nikolaristic1995/Choice_Maker/Master rad/literatura/presek razvodnika.PNG

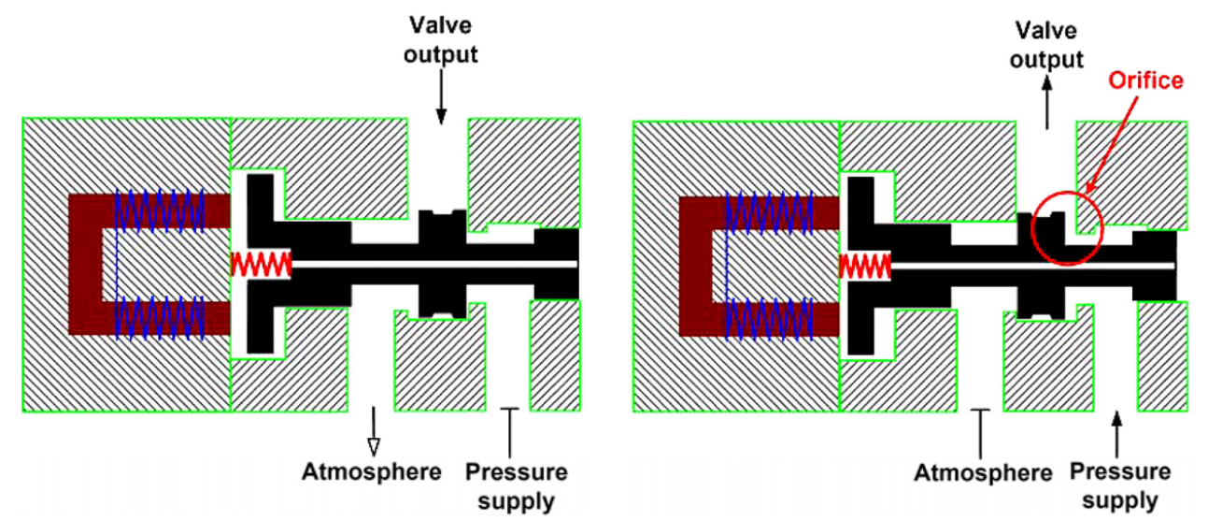
Master rad/literatura/presek razvodnika.PNG
