nikolaristic1995/Choice_Maker/Master rad/slike/aktuator realni/realni/viber_image_2020-09-10_22-50-06.jpg

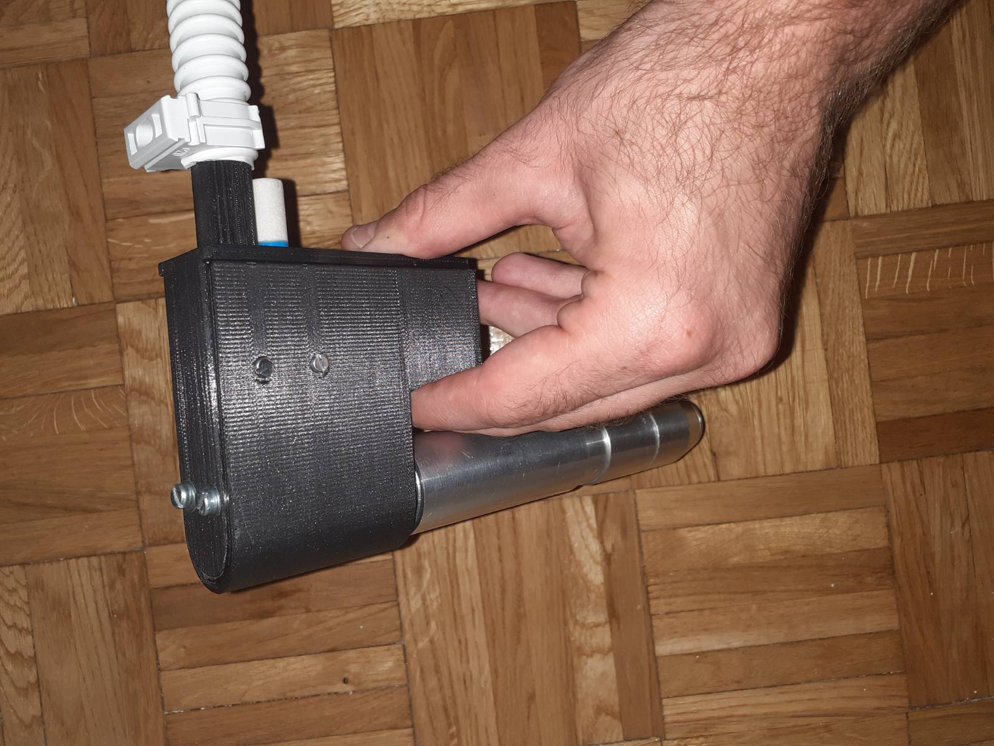
Master rad/slike/aktuator realni/realni/viber_image_2020-09-10_22-50-06.jpg
