nikolaristic1995/Choice_Maker/Master rad/word dokument/ispraviti.docx

skalarni i vektorski proizvod

razmak zarez i ‘i’ kod rednog nabrajanja

naslov promeni

uvecaj sliku projektila i membrane

font 12

crvena boja znaci obrisi, zuta je ispravljeno

reference treba redom da idu

referenca na zumiran prikaz projektila

slika8b

poziv na sliku 3-6 zica

pod povlakama oznaciti ulazne velicine

definisati zadatak u uvodu

dudic i srki

tabela eliminisi boje

dodaj nove slike i novi prilog 1

reference moraju da imaju i mesto izadavanja

Dodaj brojeve strana kako treba i sadržaj i listu slika i tabela

podesiti margine, 15 mm je ono sto si sublerom izmerio odstupanje

proveriti naslovnu stranu, da li će je preći 15 mm

Proveri sa Tanjom da li si dobro napisao zahvalincu za Vuleta

Eliminisati referencu pored dve tacke

zavrsi rad

dodai deo za zauljen vazduh pod pritiskom

1. DONE
2. NS steel zovi u četvrtak. Četvrtak brusi deo za slikanje i ureži navoje kod boba. Slikaj. Posalji Vuletu rad.
3. Zapiši poslednje poglavlje. Napiši zaključak.
4. Uneti nove slike aktuatora
5. Srediti broj strana, listu slika i tabela i sadržaj napravi
6. Pretvori u pdf i revidiraj.
7. Napravi prezentaciju.
