nikolaristic1995/Choice_Maker/Master rad/literatura/presek razvodnika i model.PNG

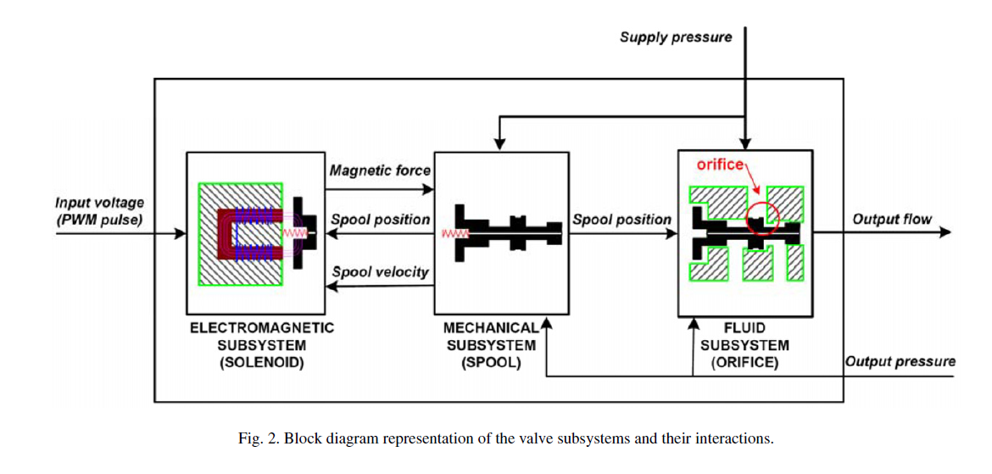
Master rad/literatura/presek razvodnika i model.PNG
