nikolaristic1995/Choice_Maker/Master rad/prezentacija/aktuator.PNG

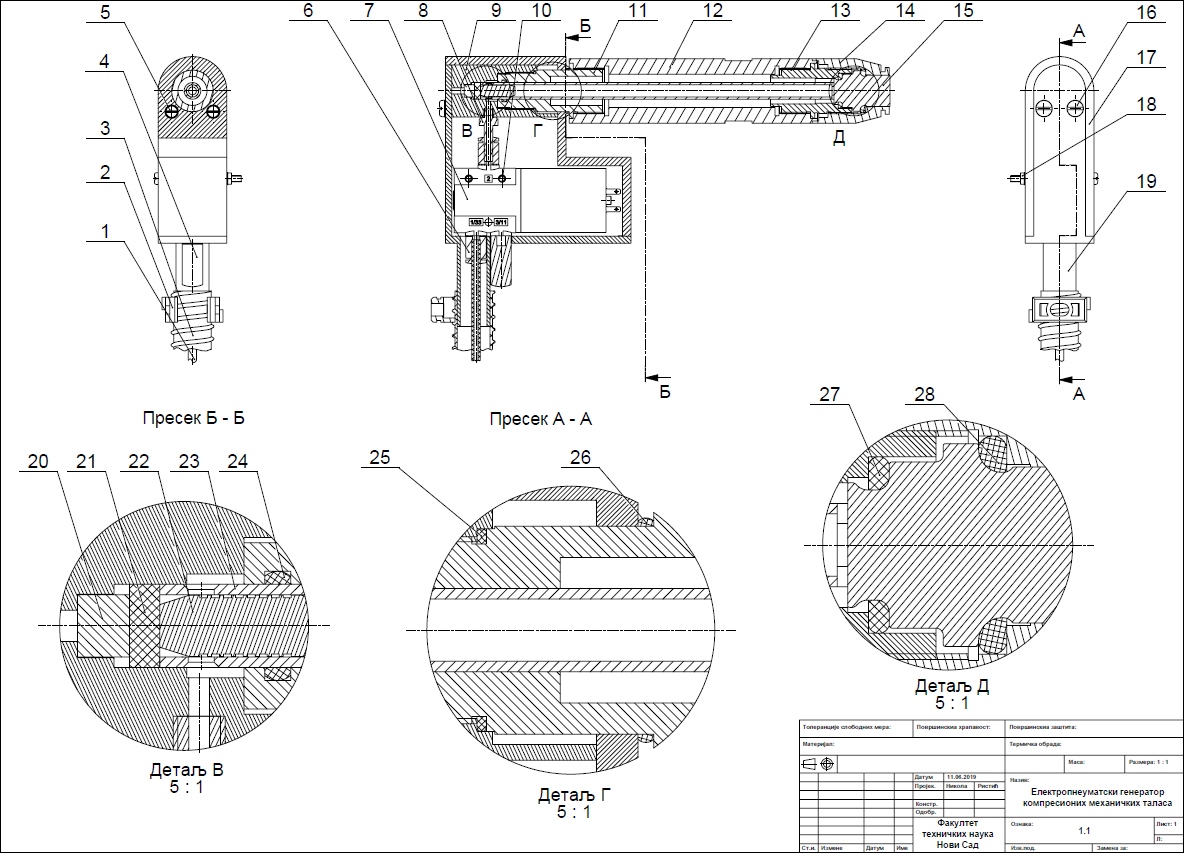
Master rad/prezentacija/aktuator.PNG
