nikolaristic1995/Choice_Maker/Master rad/prezentacija/kutija.PNG

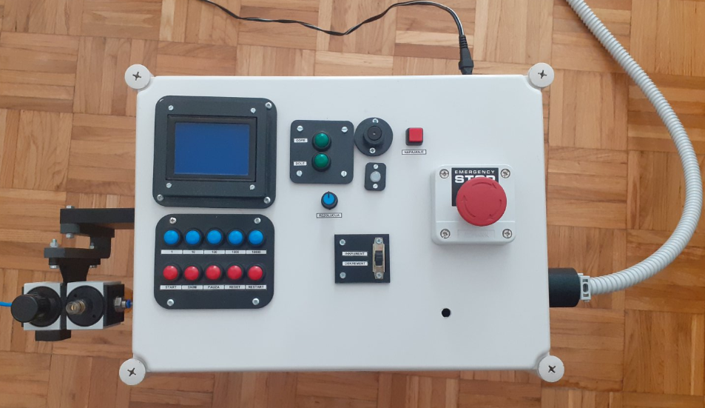
Master rad/prezentacija/kutija.PNG
