nikolaristic1995/Choice_Maker/Master rad/prezentacija/metak krozz cev.PNG

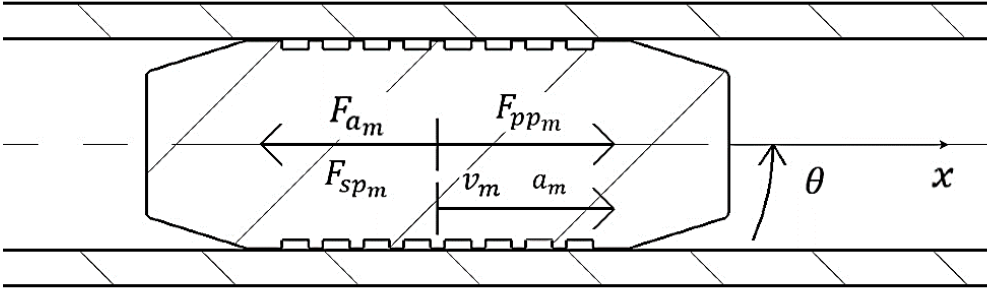
Master rad/prezentacija/metak krozz cev.PNG
