nikolaristic1995/Choice_Maker/Master rad/prezentacija/metak u početnom stanju.PNG

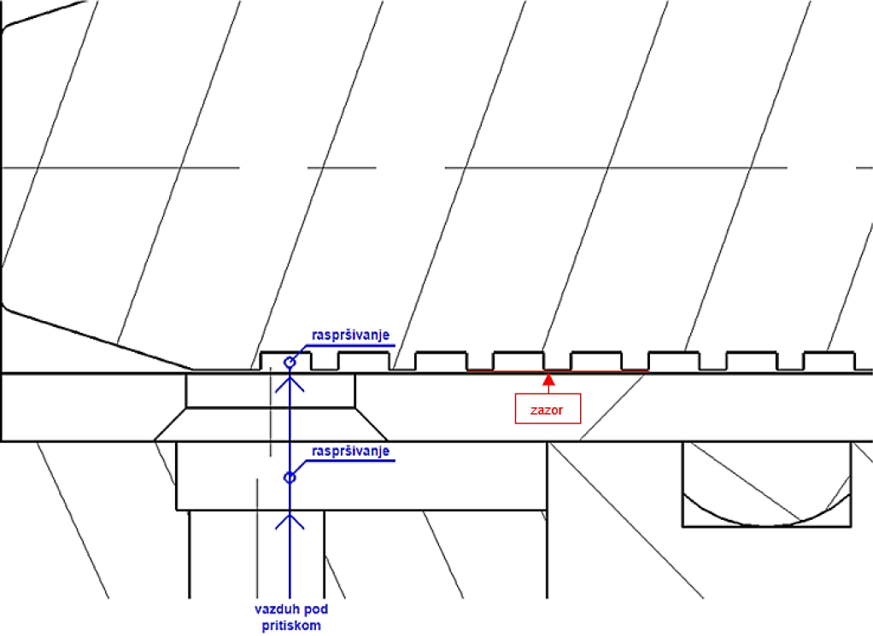
Master rad/prezentacija/metak u početnom stanju.PNG
