nikolaristic1995/Choice_Maker/Master rad/prezentacija/opruga.PNG

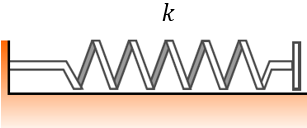
Master rad/prezentacija/opruga.PNG
