nikolaristic1995/Choice_Maker/Master rad/prezentacija/p i t.PNG

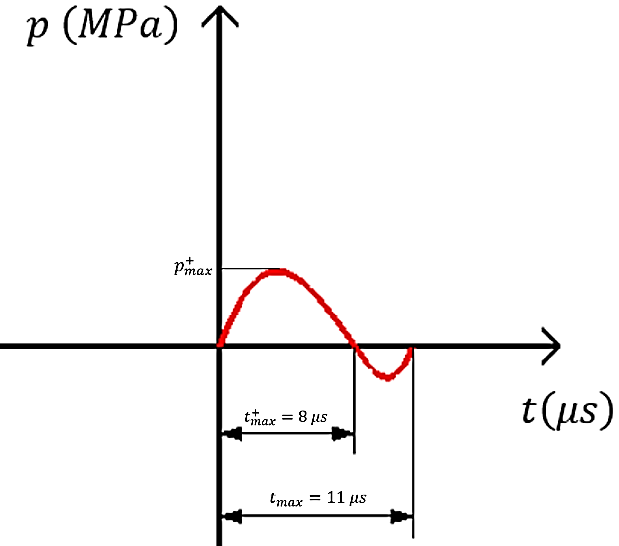
Master rad/prezentacija/p i t.PNG
