nikolaristic1995/Choice_Maker/Master rad/prezentacija/signali ventila.PNG

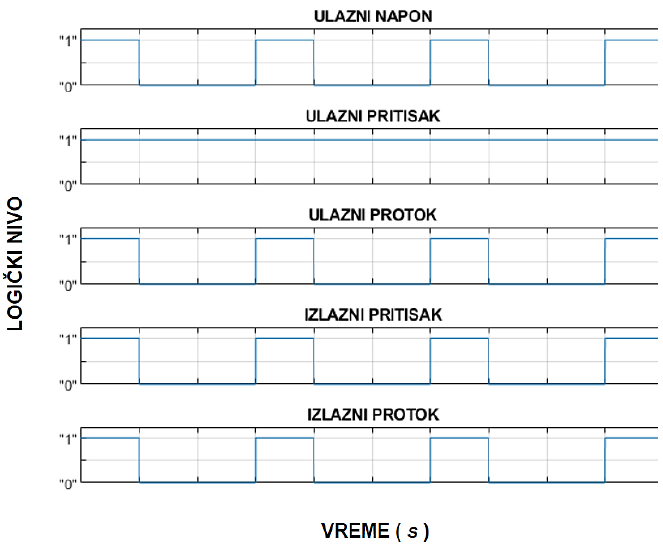
Master rad/prezentacija/signali ventila.PNG
