nikolaristic1995/Choice_Maker/Master rad/prezentacija/sudar1.PNG

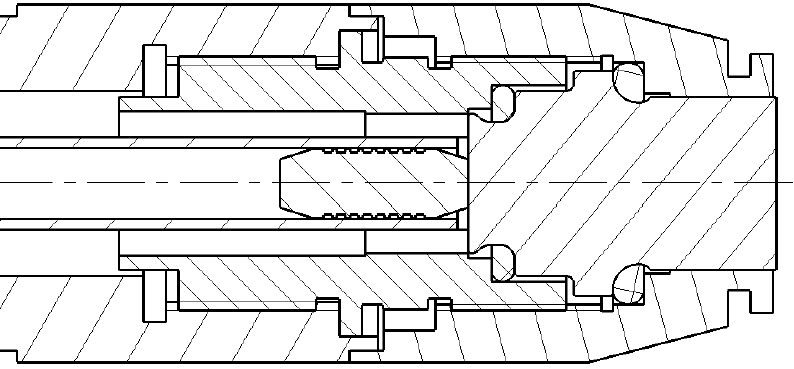
Master rad/prezentacija/sudar1.PNG
