nikolaristic1995/Choice_Maker/Master rad/prezentacija/tok vazduha do spoljašnje cevi.PNG

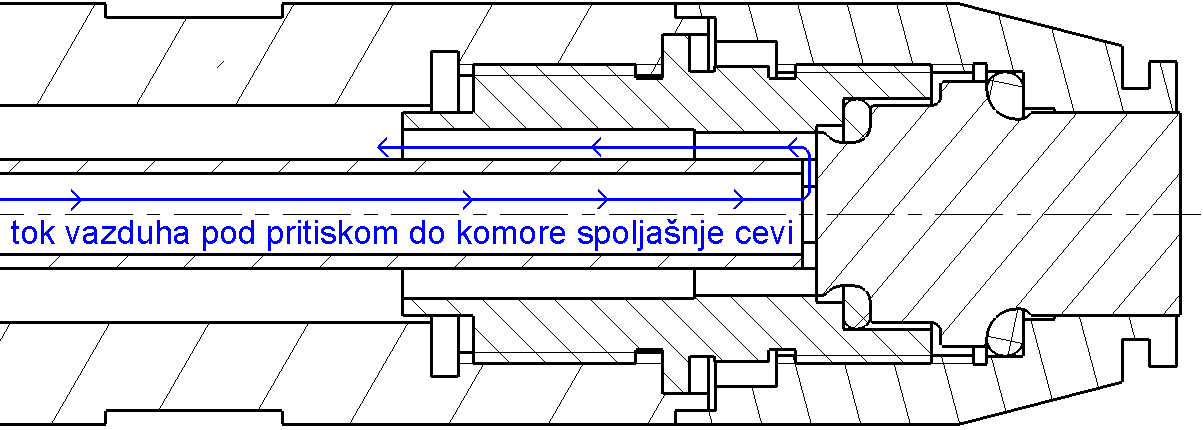
Master rad/prezentacija/tok vazduha do spoljašnje cevi.PNG
