nikolaristic1995/Choice_Maker/Master rad/prezentacija/ventil.PNG

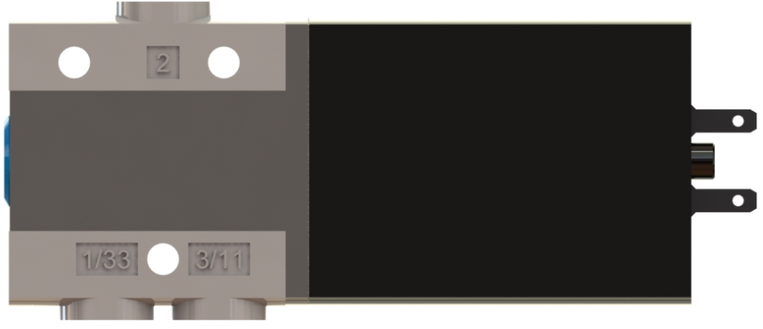
Master rad/prezentacija/ventil.PNG
