nikolaristic1995/Choice_Maker/Master rad/slike/aktuator final.JPG

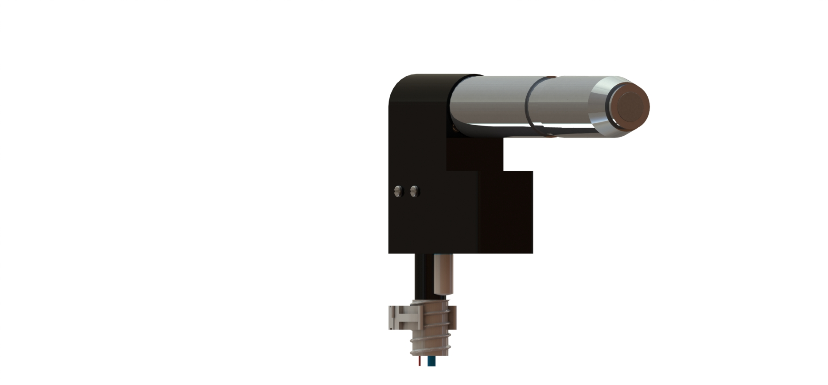
Master rad/slike/aktuator final.JPG
