nikolaristic1995/Choice_Maker/Master rad/slike/aktuator realni/1 - Copy.jpg

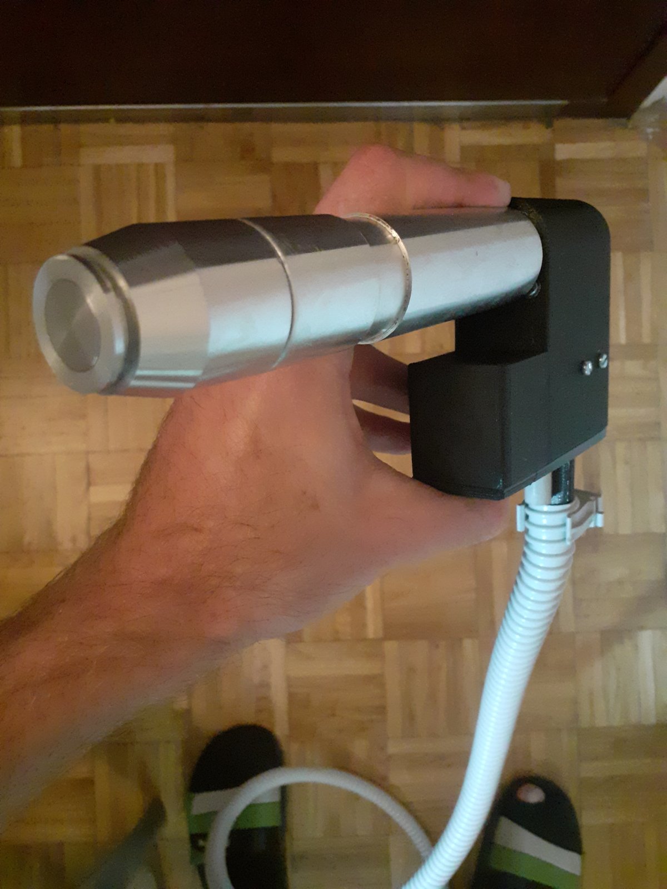
Master rad/slike/aktuator realni/1 - Copy.jpg
