nikolaristic1995/Choice_Maker/Master rad/slike/aktuator realni/2.jpg

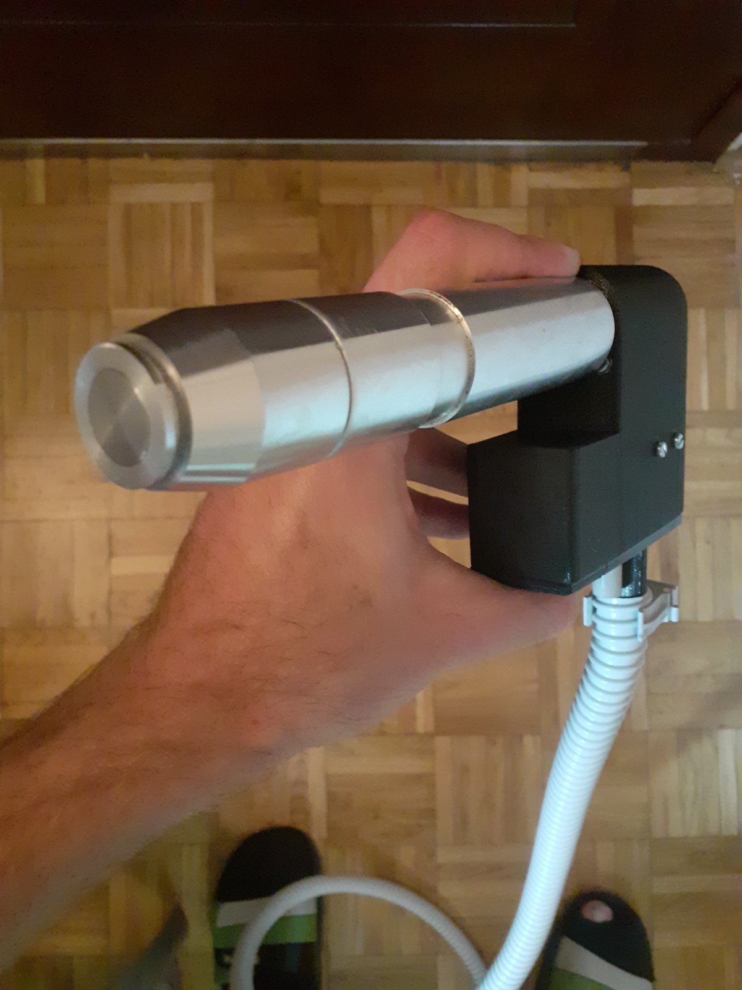
Master rad/slike/aktuator realni/2.jpg
