nikolaristic1995/Choice_Maker/Master rad/slike/aktuator realni/realni/5.jpg

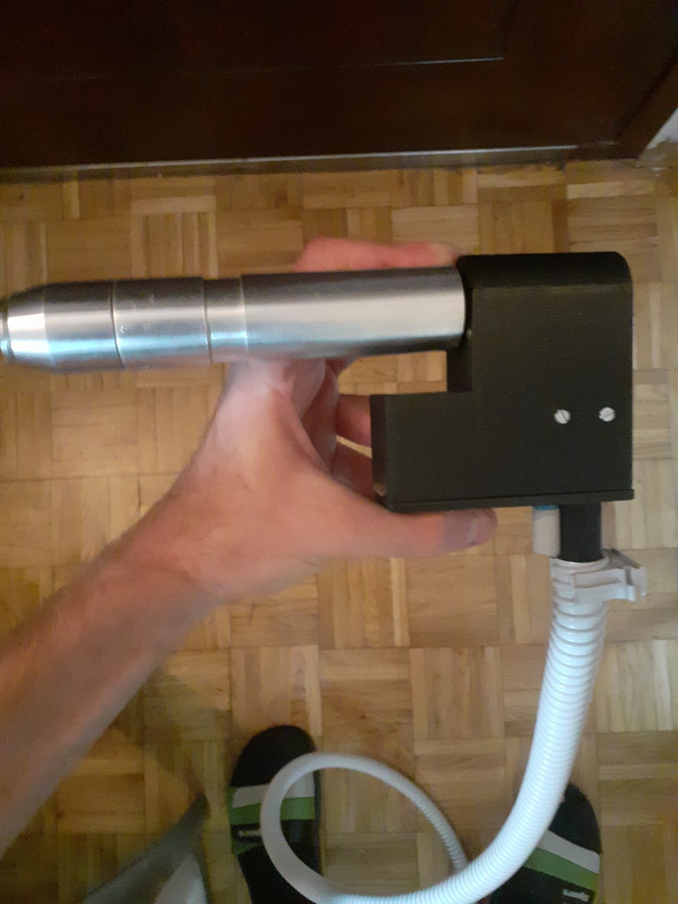
Master rad/slike/aktuator realni/realni/5.jpg
