nikolaristic1995/Choice_Maker/Master rad/slike/aktuator realni/realni/6.jpg

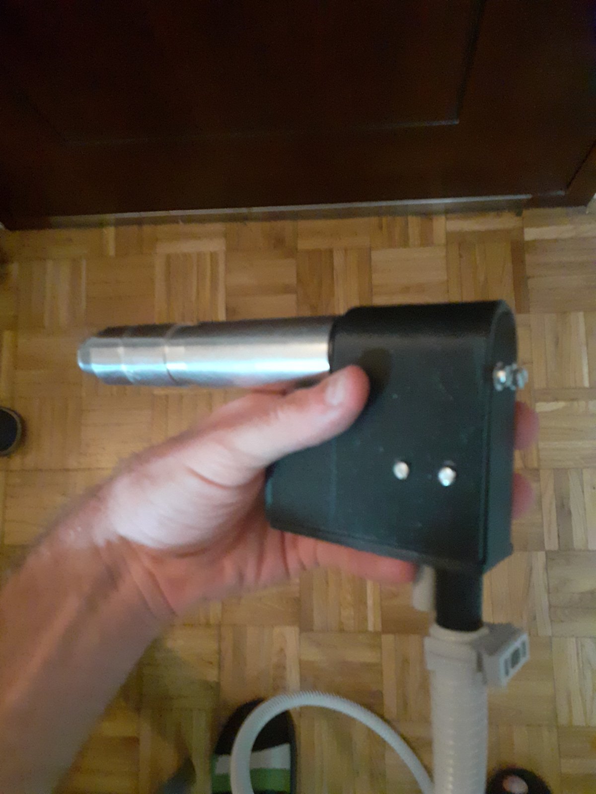
Master rad/slike/aktuator realni/realni/6.jpg
