nikolaristic1995/Choice_Maker/Master rad/slike/aktuator realni/realni/Uspeh horizontalni.jpg

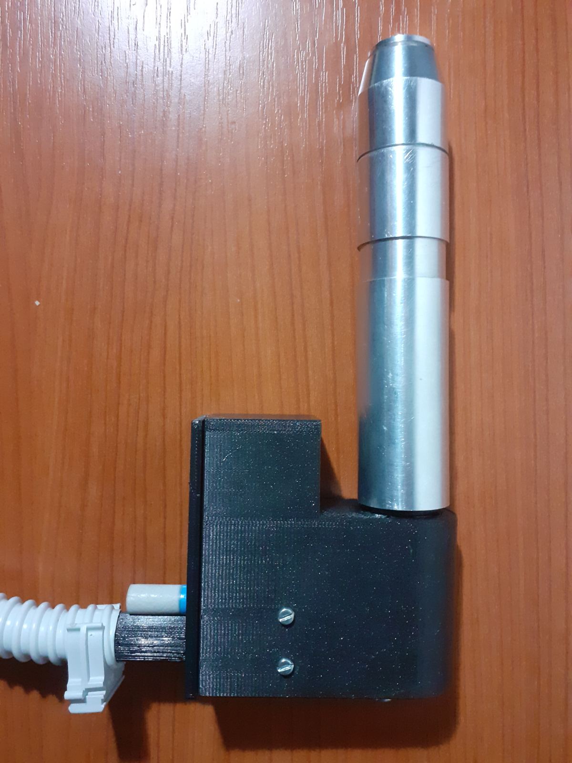
Master rad/slike/aktuator realni/realni/Uspeh horizontalni.jpg
