nikolaristic1995/Choice_Maker/Master rad/slike/aktuator realni/realni/za word1.jpg

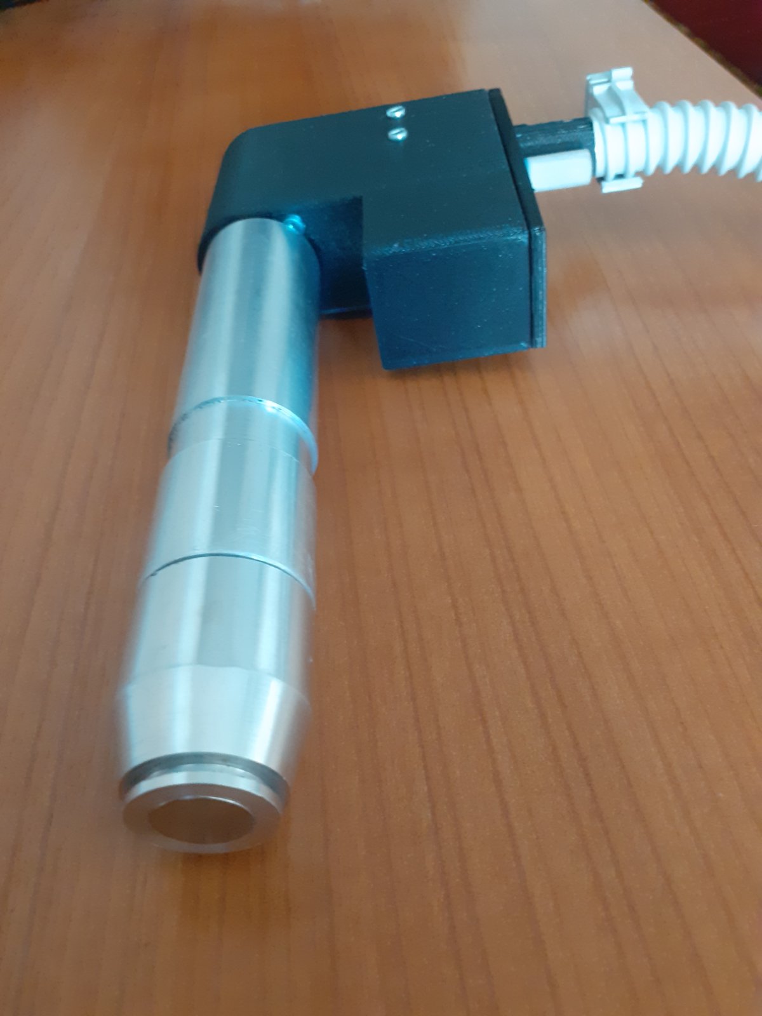
Master rad/slike/aktuator realni/realni/za word1.jpg
