nikolaristic1995/Choice_Maker/Master rad/slike/aktuator realni/USPEH/Capture.PNG

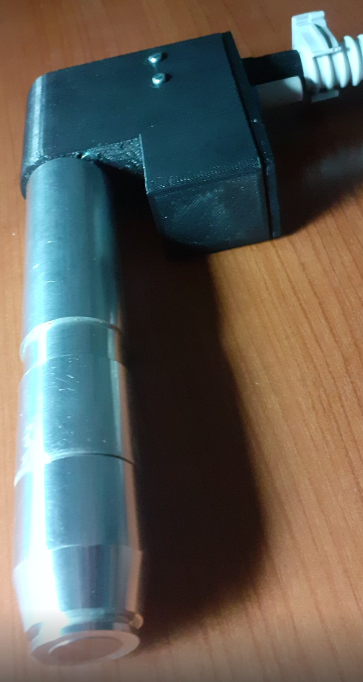
Master rad/slike/aktuator realni/USPEH/Capture.PNG
