nikolaristic1995/Choice_Maker/Master rad/slike/aktuator realni/USPEH/uspeh1.PNG

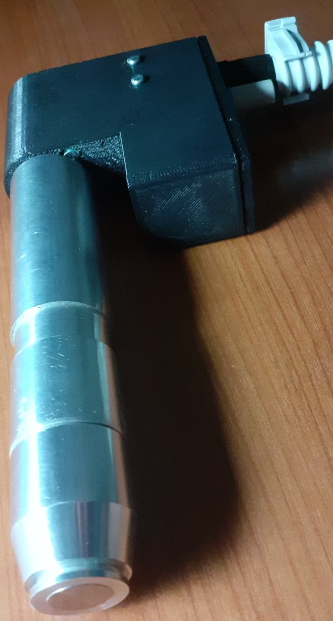
Master rad/slike/aktuator realni/USPEH/uspeh1.PNG
