nikolaristic1995/Choice_Maker/Master rad/slike/baloni na aktuatoru.PNG

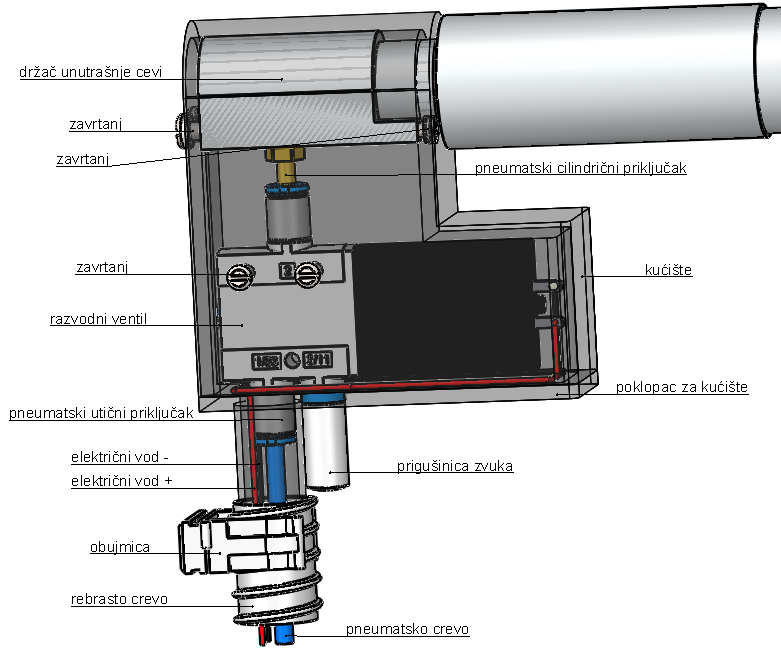
Master rad/slike/baloni na aktuatoru.PNG
