nikolaristic1995/Choice_Maker/Master rad/slike/drugi aktuator.PNG

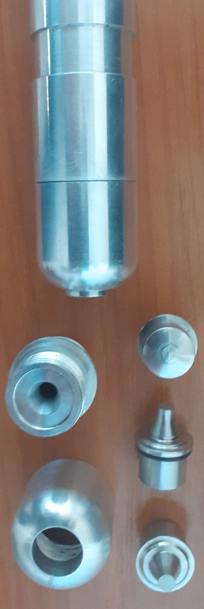
Master rad/slike/drugi aktuator.PNG
