nikolaristic1995/Choice_Maker/Master rad/slike/GLCD2.jpg

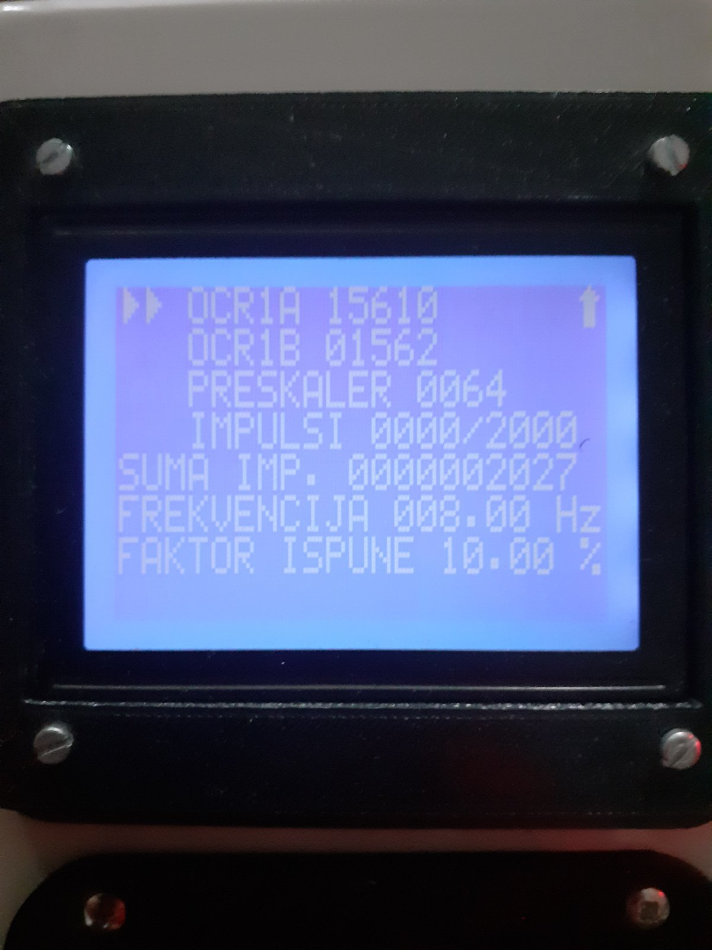
Master rad/slike/GLCD2.jpg
