nikolaristic1995/Choice_Maker/Master rad/slike/glcd.PNG

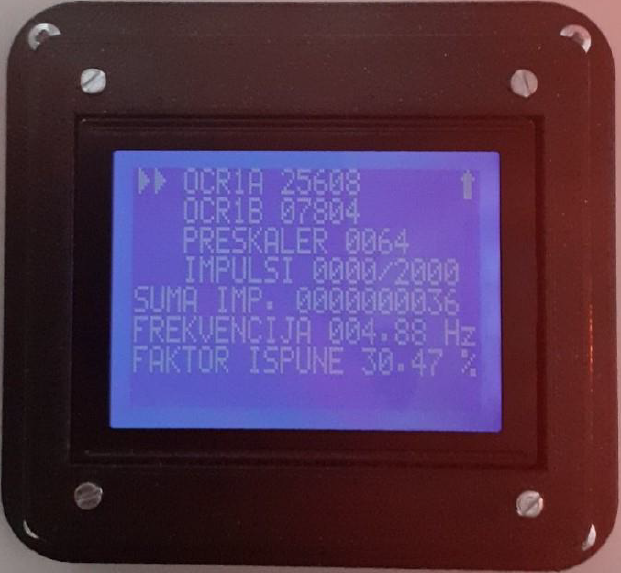
Master rad/slike/glcd.PNG
