nikolaristic1995/Choice_Maker/Master rad/slike/izbušena cev.jpg

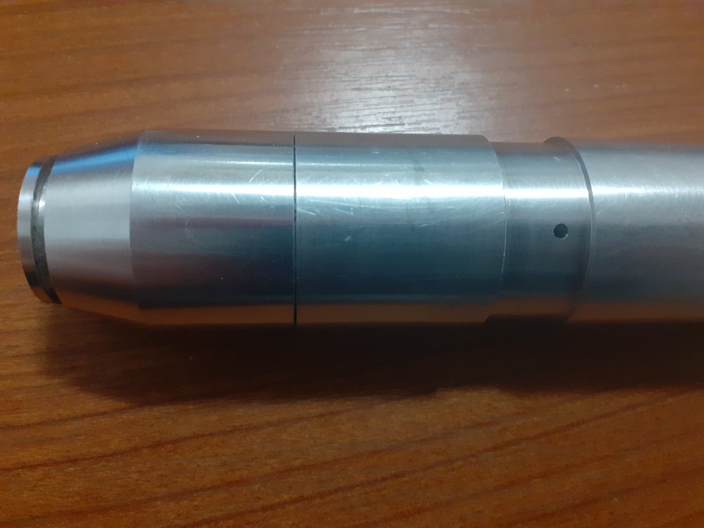
Master rad/slike/izbušena cev.jpg
