nikolaristic1995/Choice_Maker/Master rad/slike/na ovo poloziti kuciste.PNG

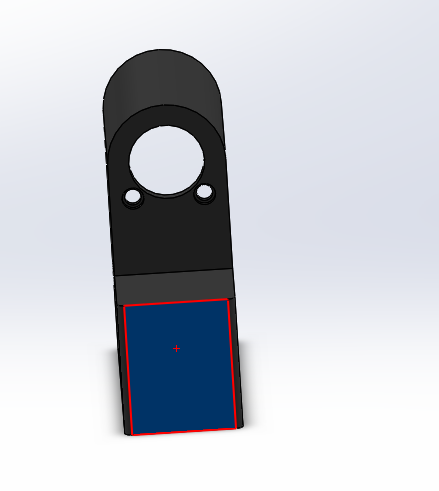
Master rad/slike/na ovo poloziti kuciste.PNG
