nikolaristic1995/Choice_Maker/Master rad/slike/nalik1.JPG

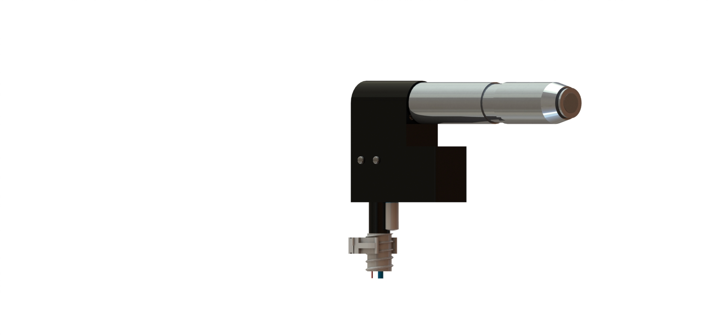
Master rad/slike/nalik1.JPG
