nikolaristic1995/Choice_Maker/Master rad/slike/nalik2.PNG

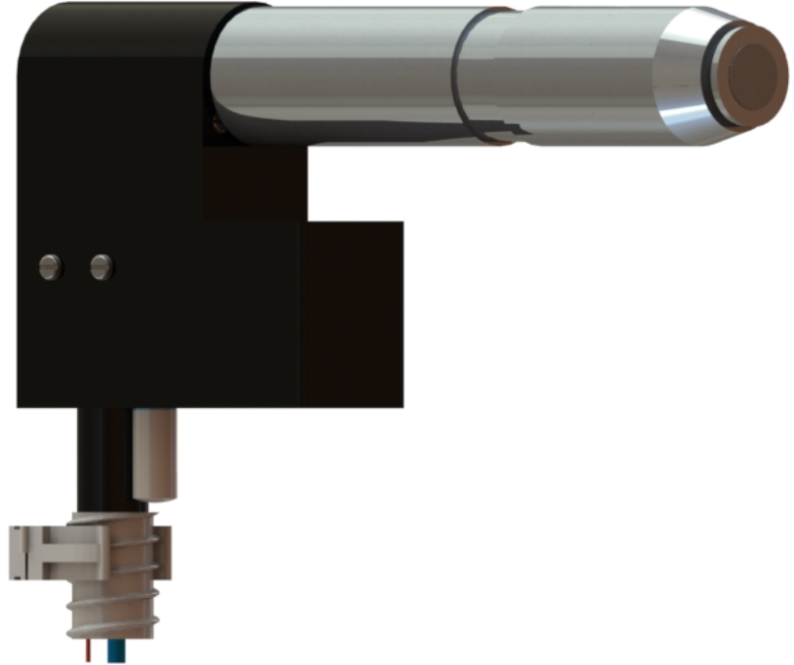
Master rad/slike/nalik2.PNG
