nikolaristic1995/Choice_Maker/Master rad/slike/razvodni ventil.PNG

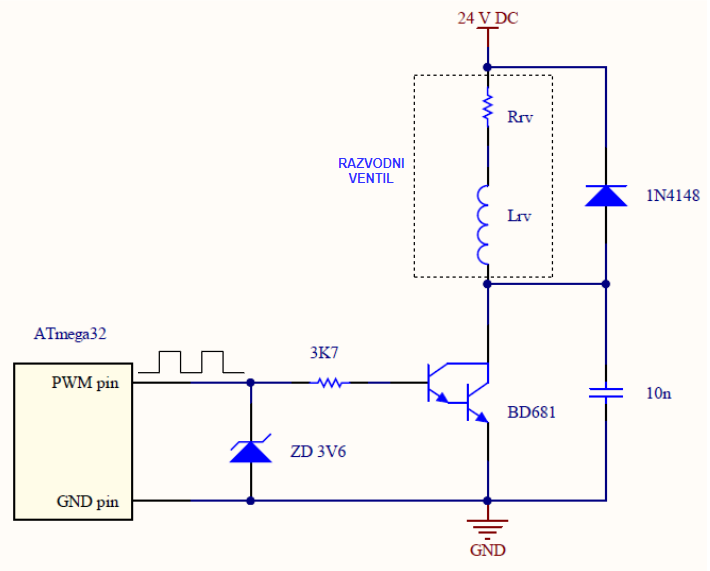
Master rad/slike/razvodni ventil.PNG
