nikolaristic1995/Choice_Maker/Master rad/slike/razvodnik.JPG

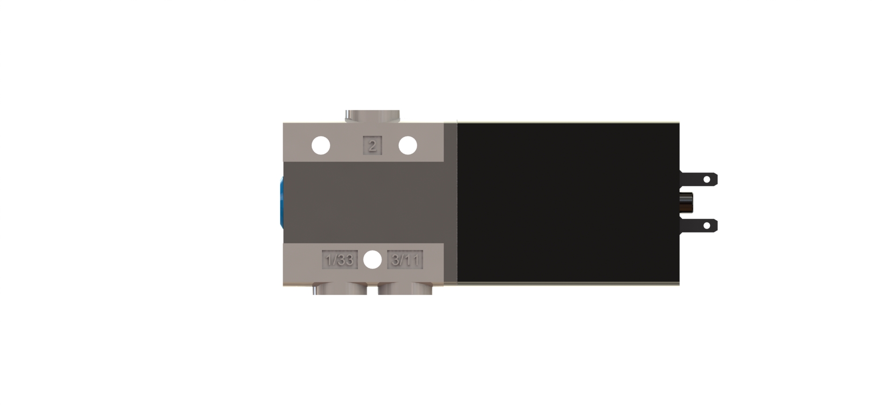
Master rad/slike/razvodnik.JPG
