nikolaristic1995/Choice_Maker/Master rad/slike/Rv.PNG

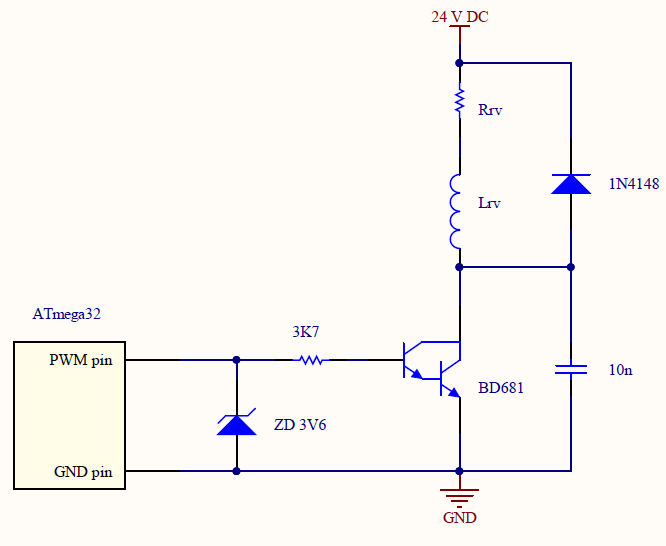
Master rad/slike/Rv.PNG
