nikolaristic1995/Choice_Maker/Master rad/slike/slika drugog aktuatora.jpg

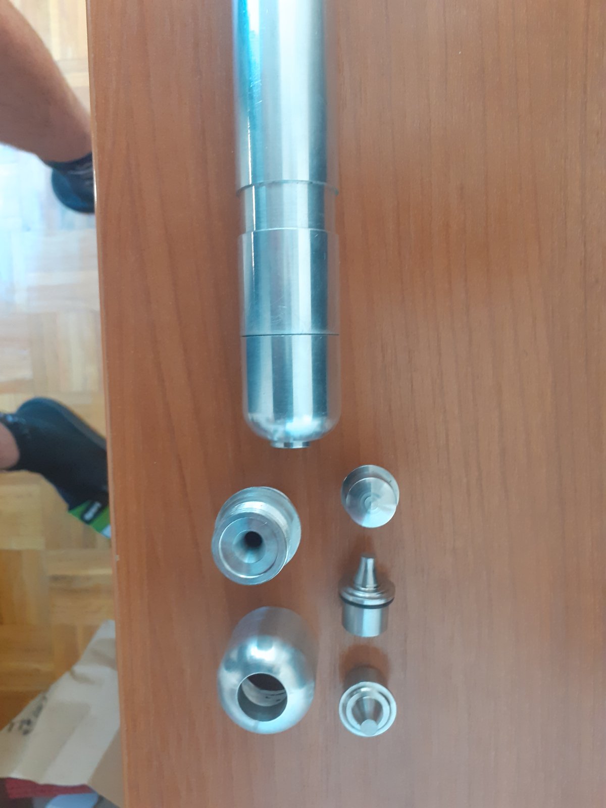
Master rad/slike/slika drugog aktuatora.jpg
