nikolaristic1995/Choice_Maker/Master rad/slike/spawn.PNG

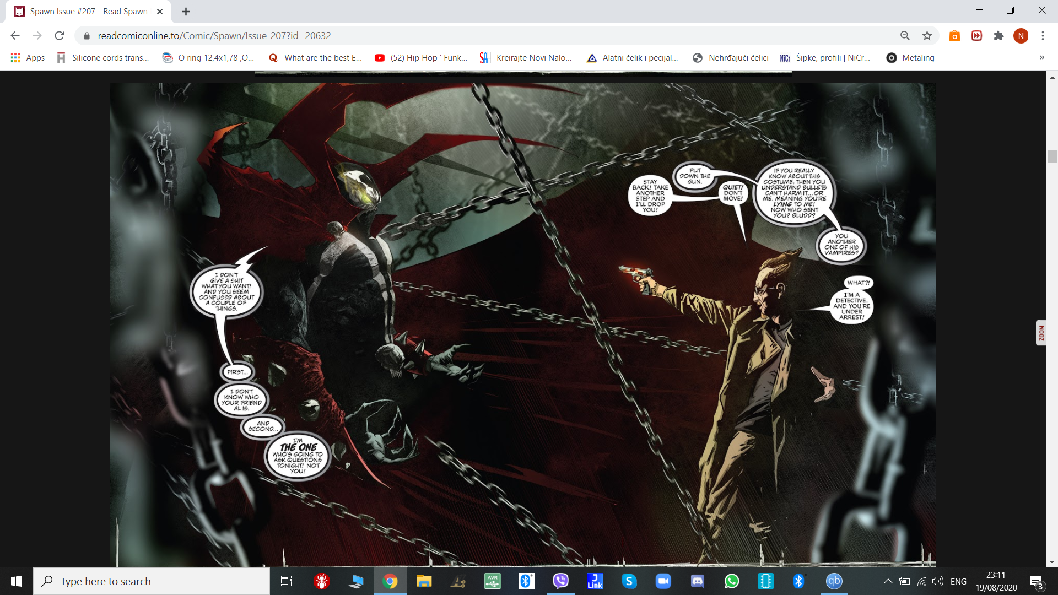
Master rad/slike/spawn.PNG
