nikolaristic1995/Choice_Maker/Master rad/slike/spoljašnja cev sa otvorom.PNG

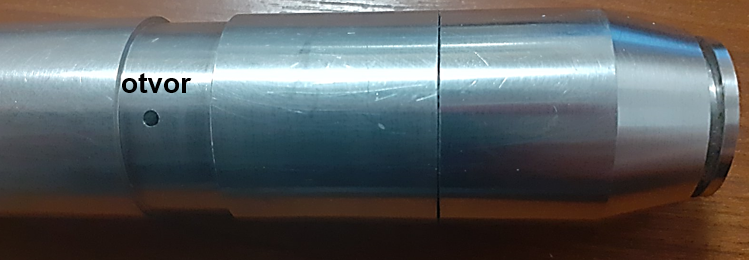
Master rad/slike/spoljašnja cev sa otvorom.PNG
