nikolaristic1995/Choice_Maker/Master rad/slike/talasno polje1.PNG

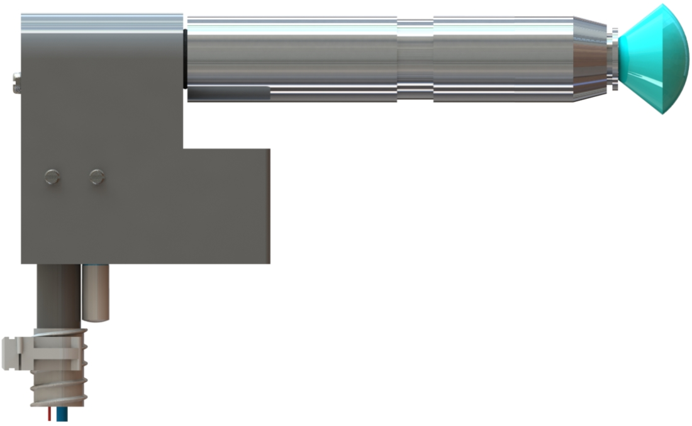
Master rad/slike/talasno polje1.PNG
