nikolaristic1995/Choice_Maker/Master rad/slike/talasno polje 3.PNG

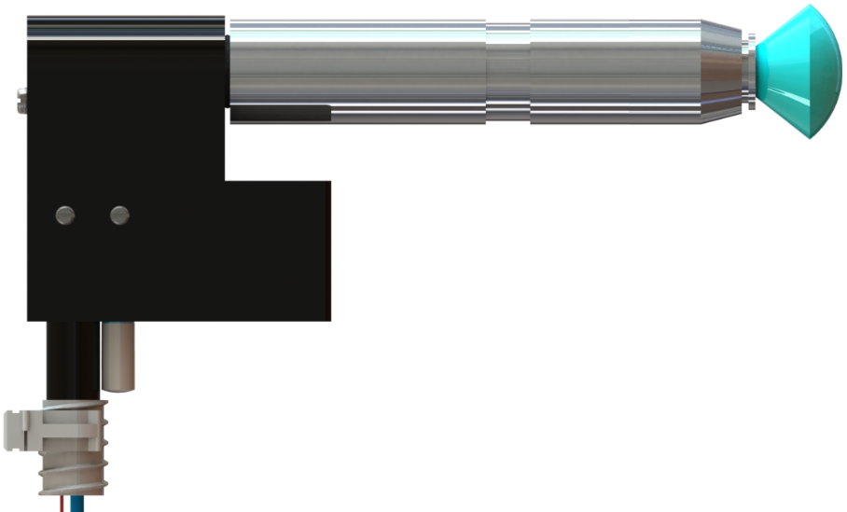
Master rad/slike/talasno polje 3.PNG
