nikolaristic1995/Choice_Maker/Master rad/slike/talasno polje.JPG

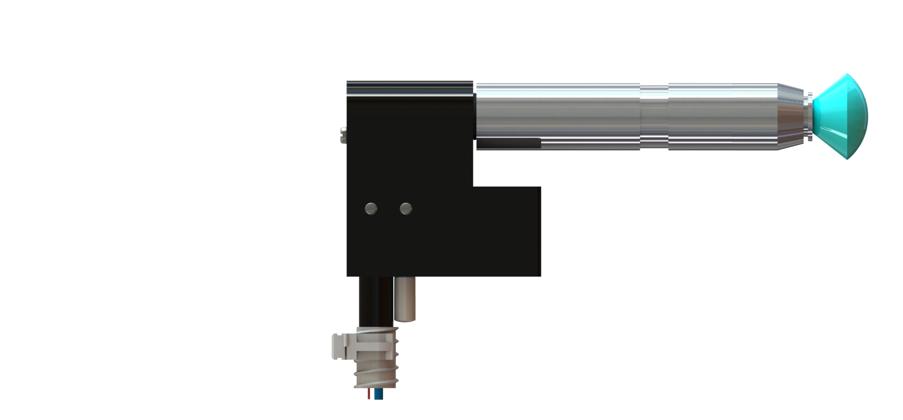
Master rad/slike/talasno polje.JPG
