nikolaristic1995/Choice_Maker/Master rad/slike/tasteri.jpg

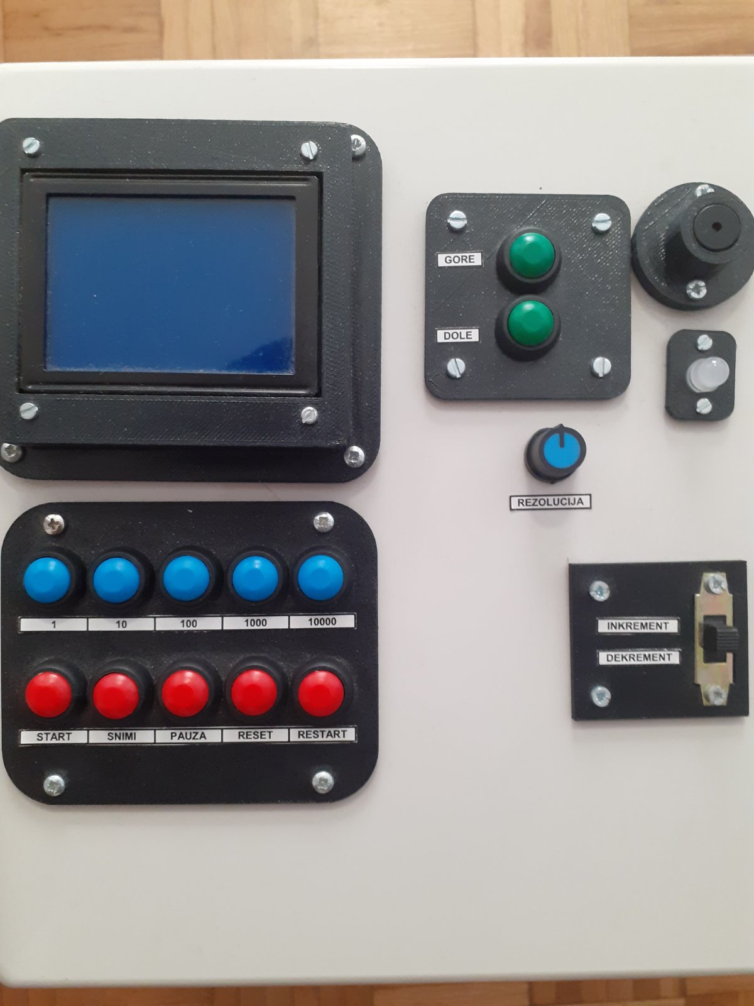
Master rad/slike/tasteri.jpg
