nikolaristic1995/Choice_Maker/Master rad/slike/tok vazduha pod pritiskom u atmosferu.PNG

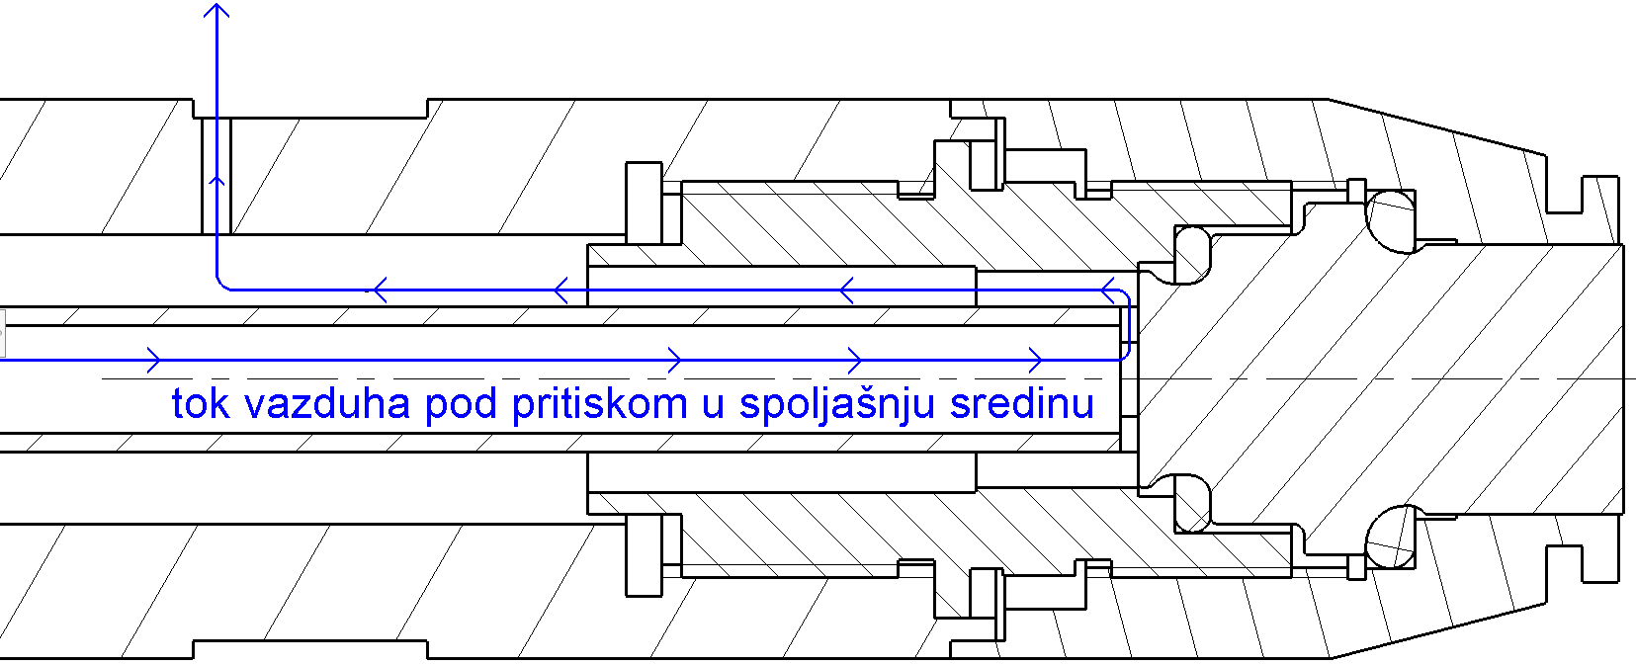
Master rad/slike/tok vazduha pod pritiskom u atmosferu.PNG
