nikolaristic1995/Choice_Maker/Master rad/slike/upravljačka tabla.PNG

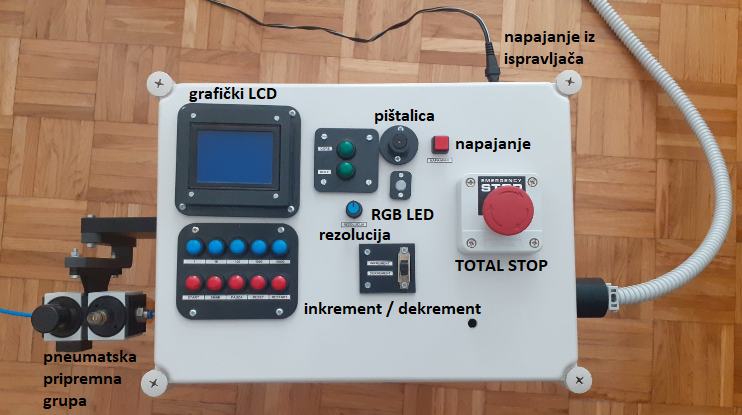
Master rad/slike/upravljačka tabla.PNG
