nikolaristic1995/Choice_Maker/Master rad/slike/za word 2.PNG

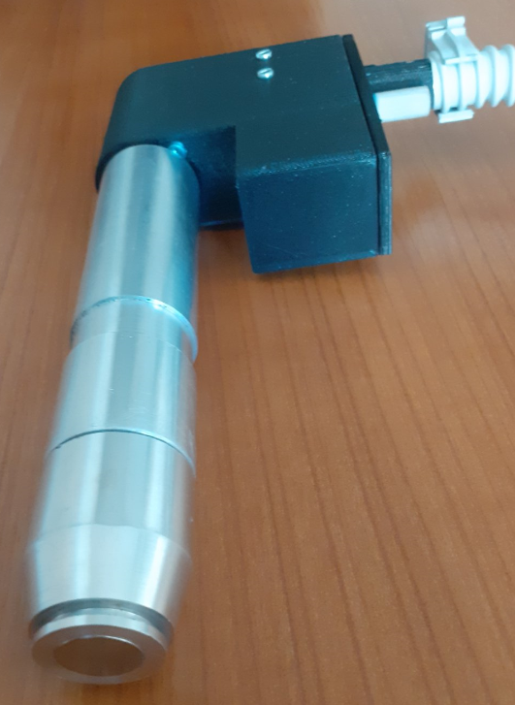
Master rad/slike/za word 2.PNG
