nikolaristic1995/Choice_Maker/Master rad/solid works projekat/izvršni organ.SLDASM

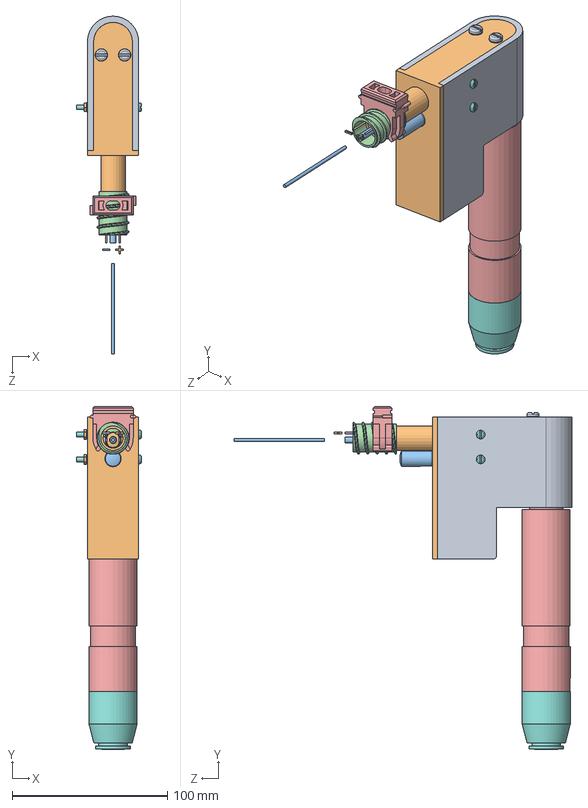
[picture p119: CAD file, 2020-09-01]
Master rad/solid works projekat/izvršni organ.SLDASM
41.8 x 220.6 x 217.3 mm
držač unutrašnje cevi
pneumatski utični priključak x 2
prigušivač zvuka
razvodni ventil 100 l u min
pneumatski cilindrični priključak
O-prsten 5,2x5x0,2
pan head cross recess screw_iso
stabilizator unutrašnje cevi
magnetni cilindar
silikonsko crevo
unutrašnja cev
projektil
spoljasnja cev
drzac projektila
membrana
držač membrane
O-prsten 10x7x1,5
O-prste 19x15x2
O-prsten 23x19x2
O-prsten 16x10x3
O-prsten 18x11x3,5
plain washer small grade a_iso x 6
slotted pan head screw_iso x 4
hex thin nut gradeb_iso x 2
pneumatsko crevo 4x2
rebrasto crevo
obujmica
kabel +
kabel -
pan slotted head screw_as x 2
ulazni vazduh
