nikolaristic1995/Choice_Maker/Master rad/za 3D stampu/assembly.SLDASM

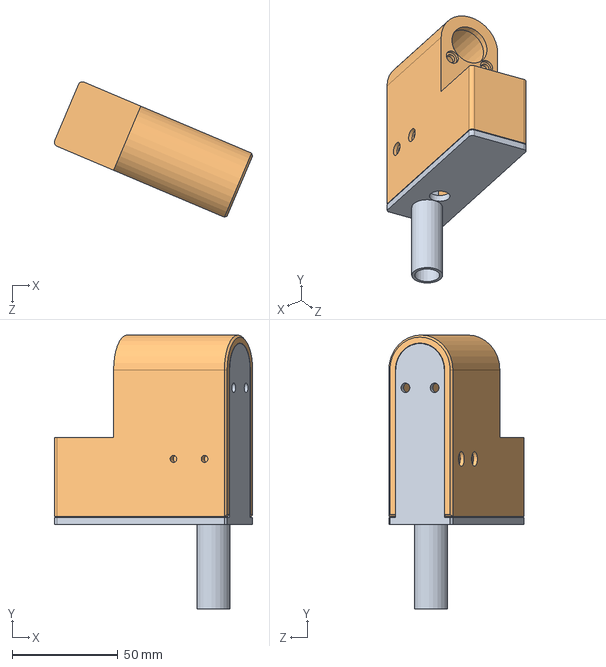
[picture p120: CAD file, 2020-09-04]
Master rad/za 3D stampu/assembly.SLDASM
94.0 x 129.8 x 64.2 mm
poklopac
kuciste
