nikolaristic1995/Choice_Maker/Master rad/solid works projekat/ulazni vazduh.SLDPRT

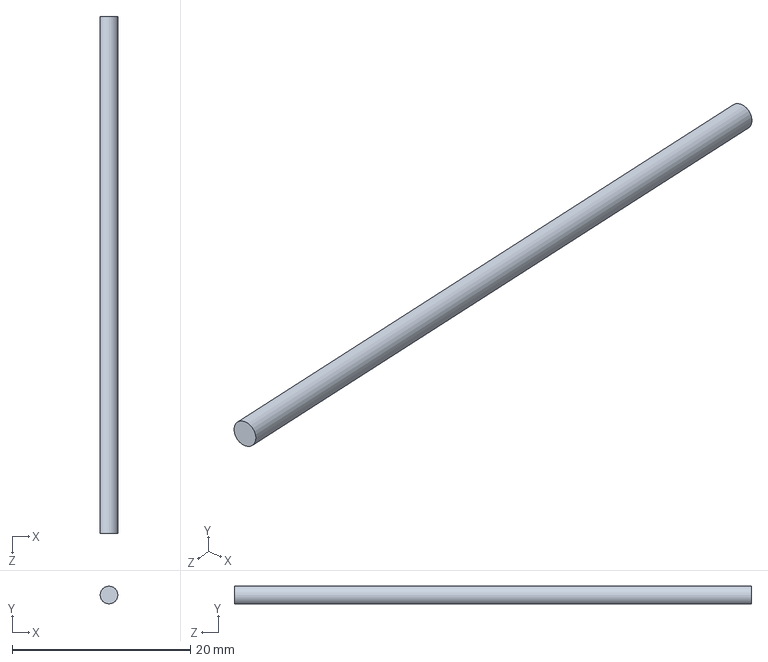
[picture p121: CAD file, 2020-09-01]
Master rad/solid works projekat/ulazni vazduh.SLDPRT
2.00 x 2.00 x 58.0 mm
