nikolaristic1995/Choice_Maker/Master rad/za 3D stampu/kuciste.SLDPRT

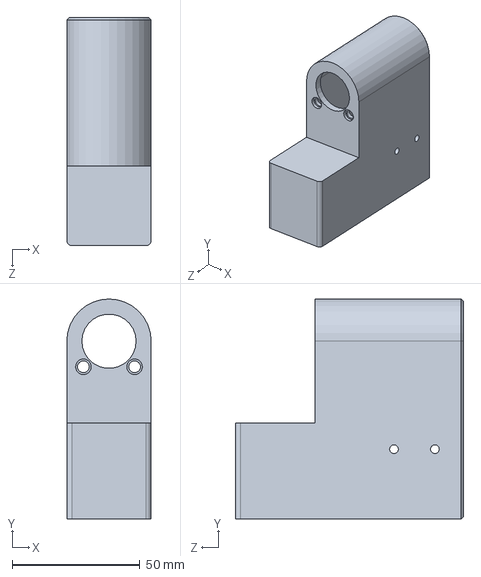
[picture p122: CAD file, 2020-09-08]
Master rad/za 3D stampu/kuciste.SLDPRT
33.0 x 86.0 x 89.2 mm
