nikolaristic1995/Choice_Maker/Master rad/za 3D stampu/poklopac.SLDPRT

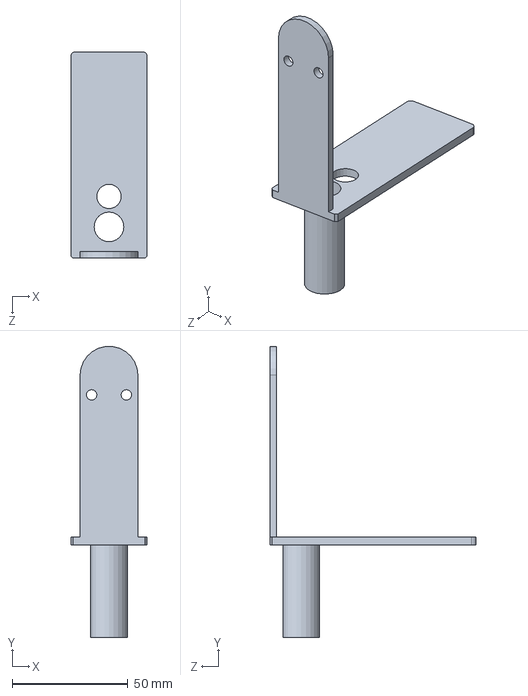
[picture p123: CAD file, 2020-09-04]
Master rad/za 3D stampu/poklopac.SLDPRT
33.0 x 125.7 x 89.2 mm
