nikolaristic1995/Choice_Maker/Master rad/solid works projekat/minus.SLDPRT

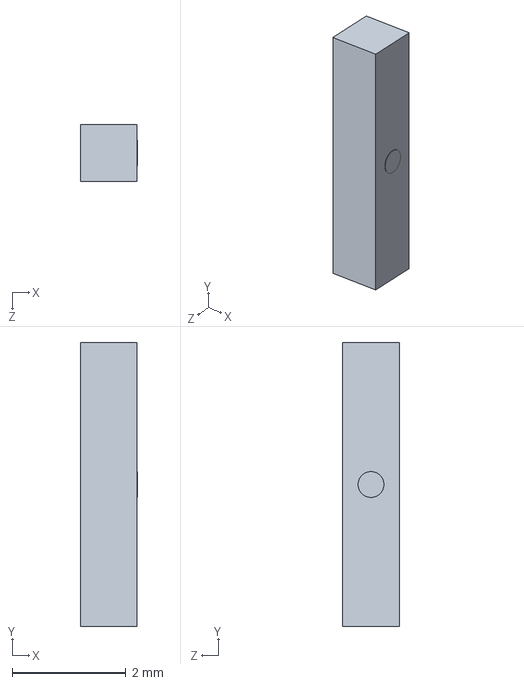
[picture p124: CAD file, 2020-08-31]
Master rad/solid works projekat/minus.SLDPRT
1.01 x 5.00 x 1.00 mm
