nikolaristic1995/Choice_Maker/Master rad/solid works projekat/poklopac.SLDPRT

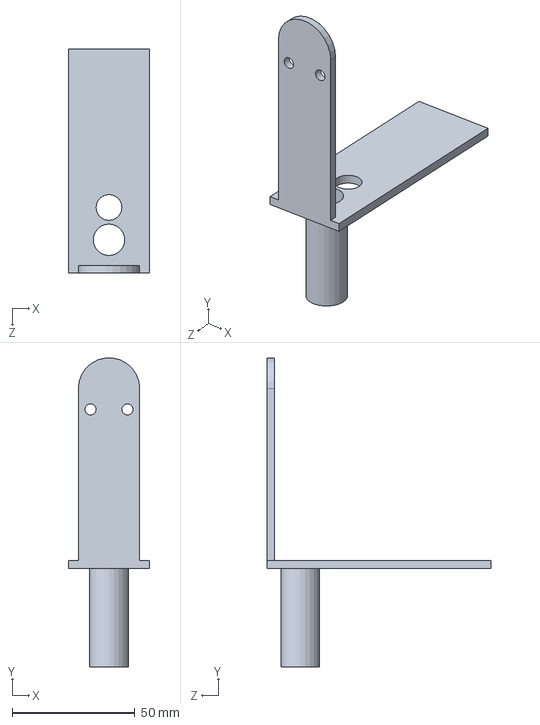
[picture p125: CAD file, 2020-08-31]
Master rad/solid works projekat/poklopac.SLDPRT
33.0 x 125.7 x 91.2 mm
