nikolaristic1995/Choice_Maker/Master rad/solid works projekat/plus.SLDPRT

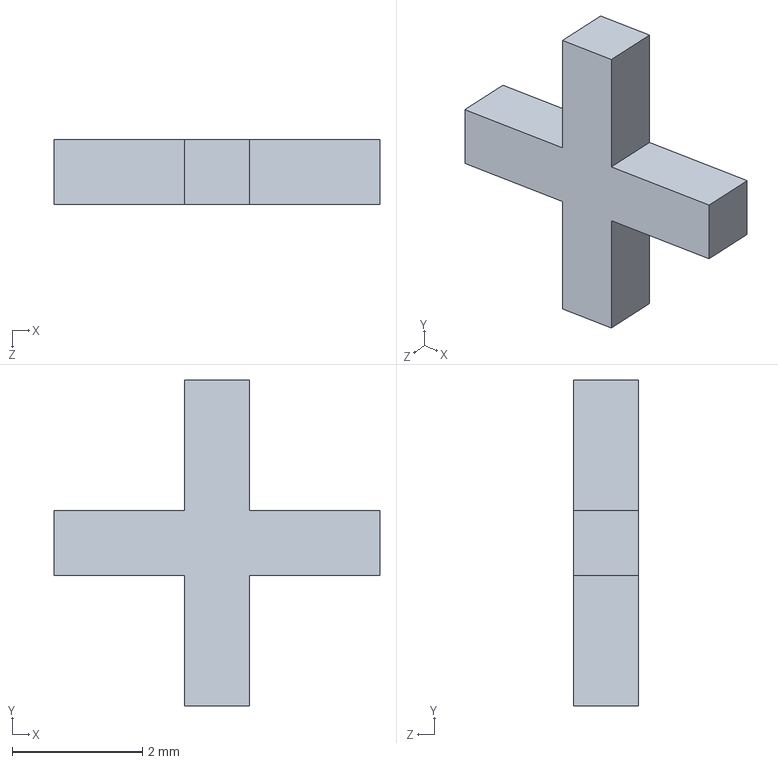
[picture p126: CAD file, 2020-08-31]
Master rad/solid works projekat/plus.SLDPRT
5.00 x 5.00 x 1.00 mm
