nikolaristic1995/Choice_Maker/Master rad/solid works projekat/kućište.SLDPRT

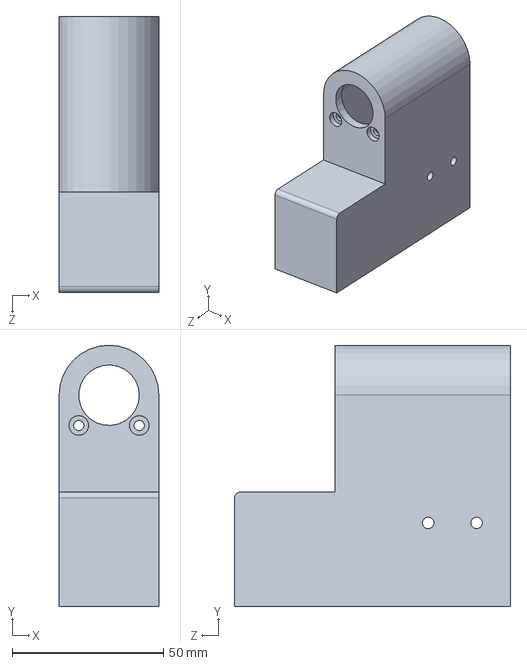
[picture p127: CAD file, 2020-08-30]
Master rad/solid works projekat/kućište.SLDPRT
33.0 x 86.4 x 91.2 mm
