nikolaristic1995/Choice_Maker/(list of files, cad)

Other CAD files:
Master rad/prilozi/prilog 4/drzac membrane.SLDDRW
Master rad/za 3D stampu/kuciste.STL
Master rad/za 3D stampu/poklopac.STL
