nikolaristic1995/Choice_Maker/Master rad/upravljanje razvodnikom/upravljanjeRazvodnikom/upravljanjeRazvodnikom.pdf

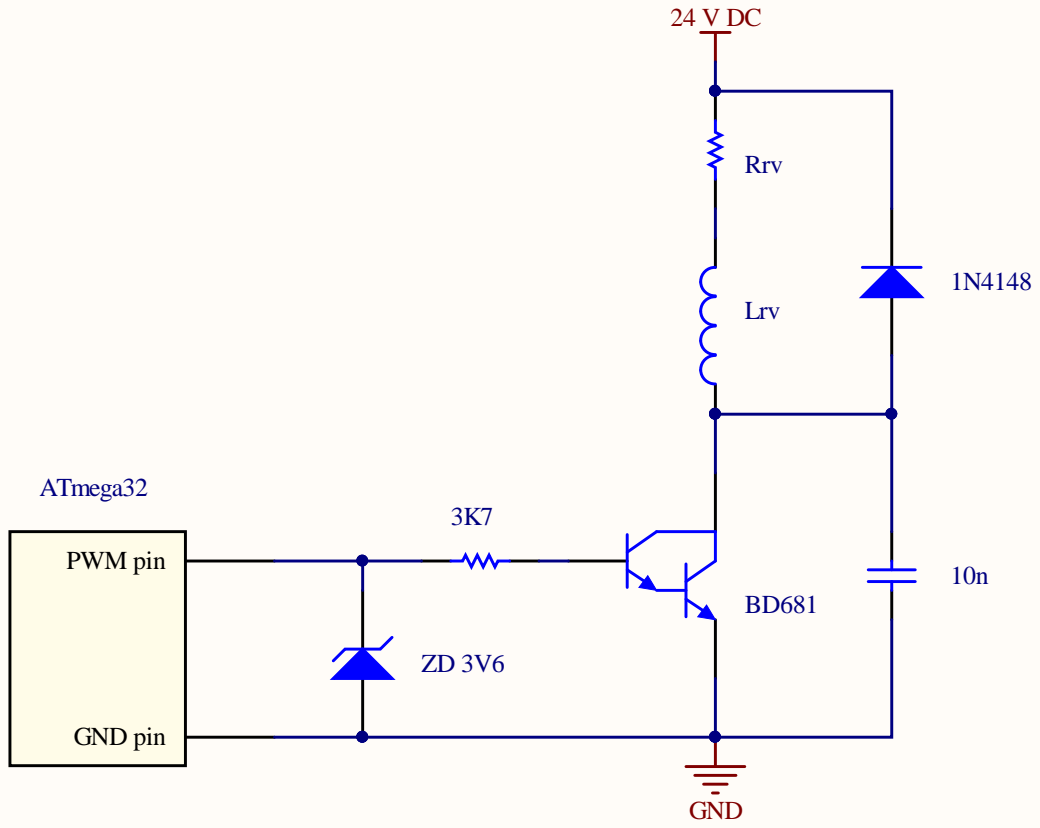
[picture p128: page 1]

Siz e | Nu mb e r | Re visio n

: 1 4/0 8/2 0 2 0 | Sh e et o f
File : C:\ U s e rs\.. \u p r avlja nje r a z vo d nik o m.Sc h D o c | D r awn By :

Comment | Description | Designator | Footprint | LibRef | Quantity
ATmega32 | | | | Component_1 | 1
Diode | Default Diode | 1N4148 | SMC | Diode | 1
Res Semi | Semiconductor Resistor | 3K7 | AXIAL-0.5 | Res Semi | 1
Cap | Capacitor | 10n | RAD-0.3 | Cap | 1
Inductor | Inductor | Lrv | 0402-A | Inductor | 1
BD681 | NPN Darlington Bipolar Transistor | Q? | TO-92 | NPN1 | 1
Rrv | Resistor | Rrv | AXIAL-0.3 | Res1 | 1
D Zener | Zener Diode | ZD 3V6 | DIODE-0.7 | D Zener | 1
