nikolaristic1995/Choice_Maker/Master rad/električna šema/električna šema.pdf

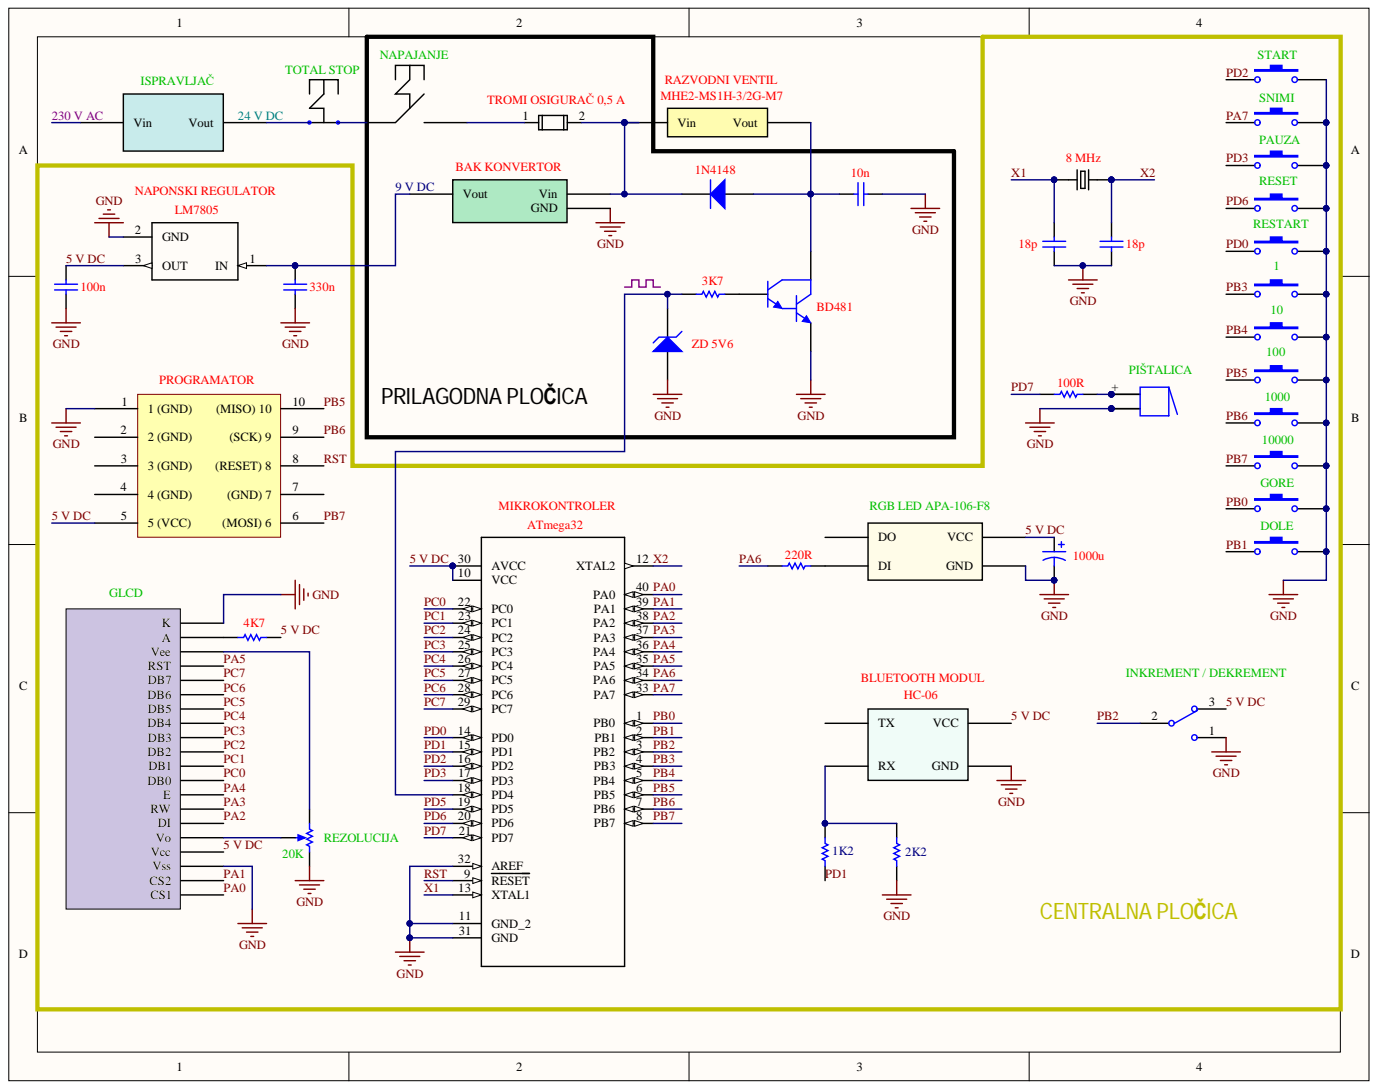
[picture p129: page 1]
