nikolaristic1995/Choice_Maker/Master rad/prilozi/prilog 4/drzac membrane konveksne.PDF

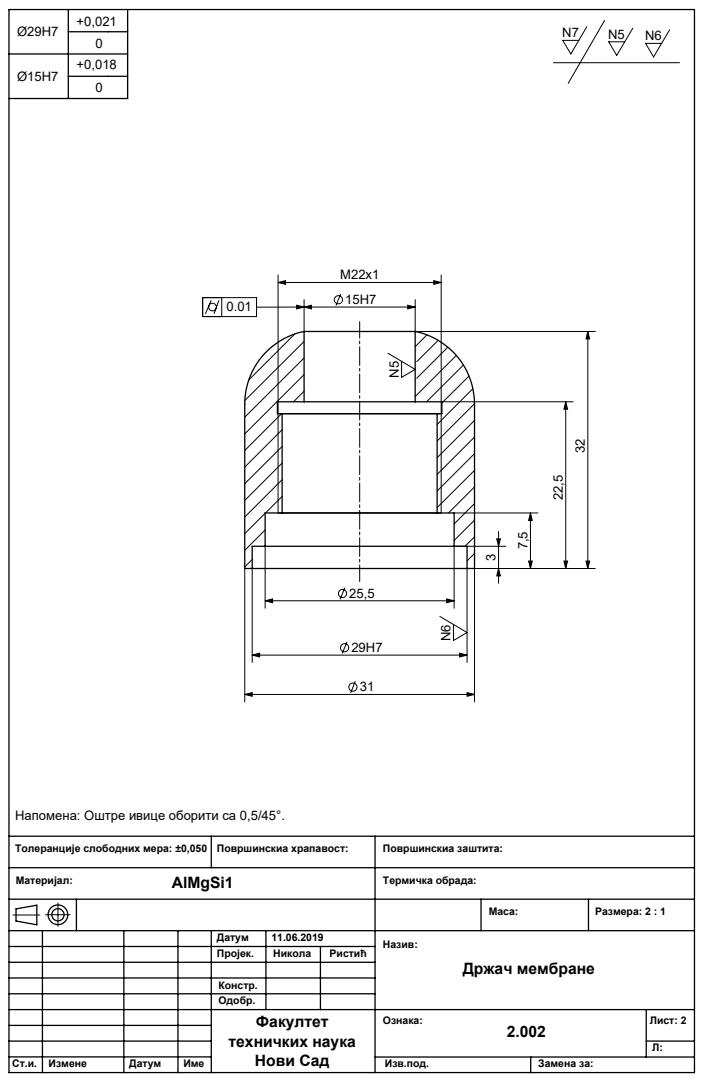
[picture p130: page 1]
Толеранције слободних мера: ±0,050 Површинскиа храпавост:; Површинскиа заштита:; Материјал:; Термичка обрада:; Маса:; Размера: 2 : 1; Ознака:; Лист: 2; Изв.под.; Замена за:; Ст.и. Измене; Датум; Име; техничких наука Нови Сад; Држач мембране

Напомена: Оштре ивице оборити са 0,5/45°.
