nikolaristic1995/Choice_Maker/Master rad/prilozi/prilog 4/membrana konveksna.pdf

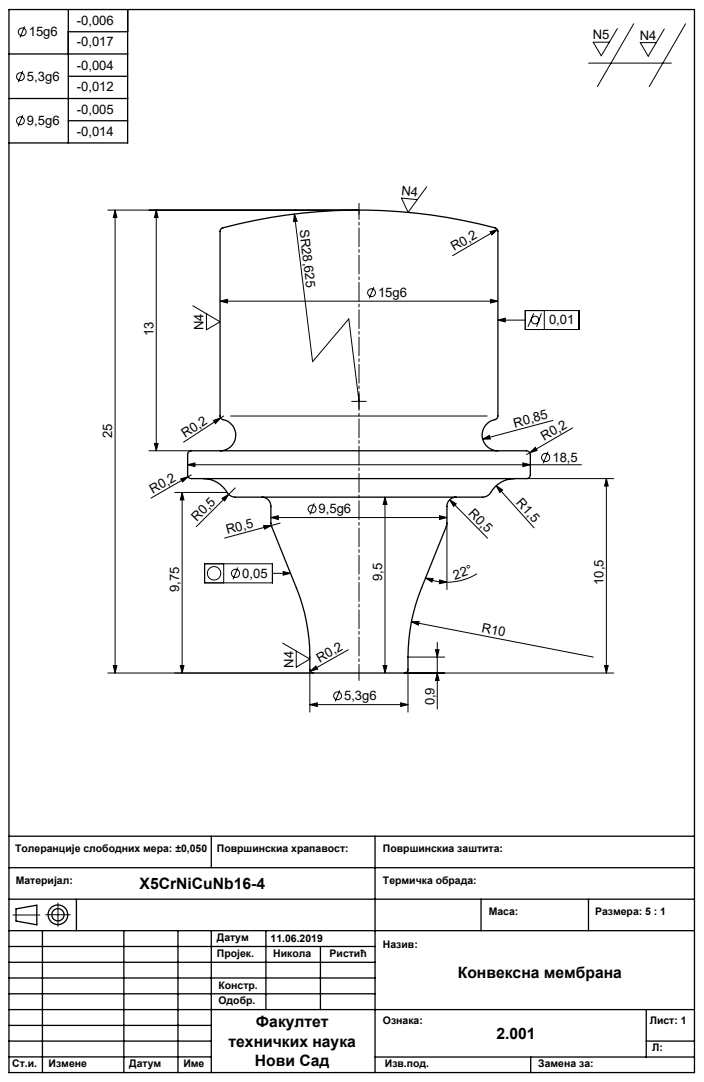
[picture p131: page 1]
Толеранције слободних мера: ±0,050 Површинскиа храпавост:; Површинскиа заштита:; Материјал:; Термичка обрада:; Маса:; Размера: 5 : 1; Ознака:; Лист: 1; Изв.под.; Замена за:; Ст.и. Измене; Датум; Име; техничких наука Нови Сад; Конвексна мембрана
