nikolaristic1995/Choice_Maker/Master rad/prilozi/prilog 4/zaobljen drzac projektilaa.pdf

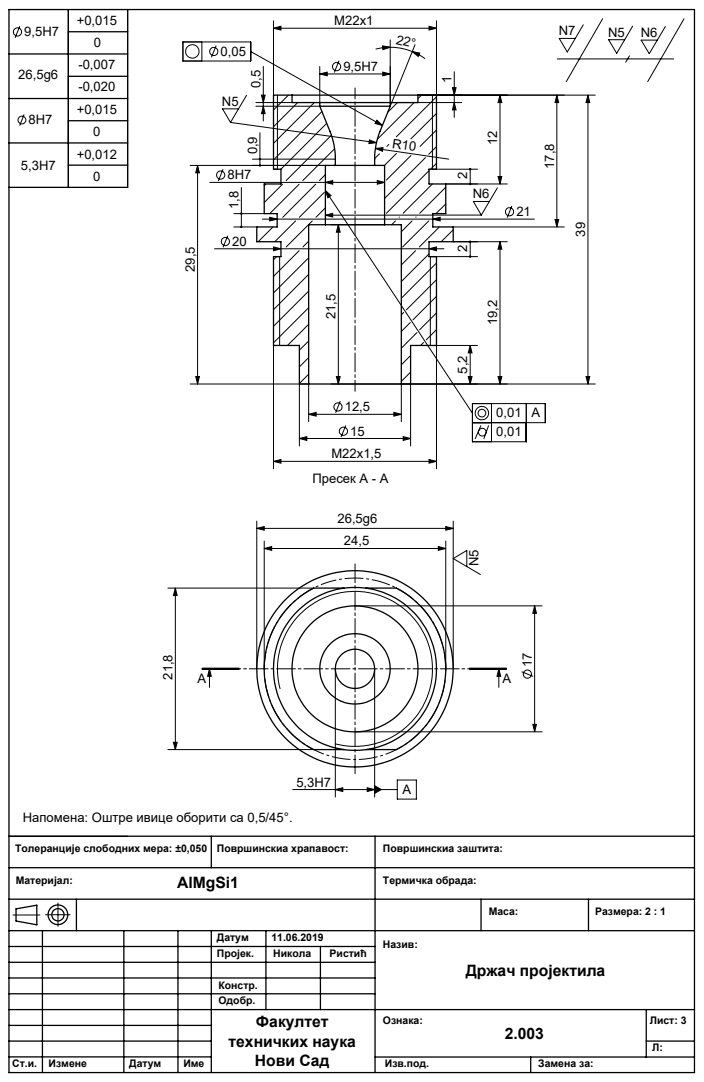
[picture p132: page 1]
Пресек А - А; Толеранције слободних мера: ±0,050 Површинскиа храпавост:; Површинскиа заштита:; Материјал:; Термичка обрада:; Маса:; Размера: 2 : 1; Ознака:; Лист: 3; Изв.под.; Замена за:; Ст.и. Измене; Датум; Име; техничких наука Нови Сад; Држач пројектила

Напомена: Оштре ивице оборити са 0,5/45°.
