nikolaristic1995/Choice_Maker/Master rad/upravljanje razvodnikom/upravljanjeRazvodnikom/upravljanje razvodnikom.pdf

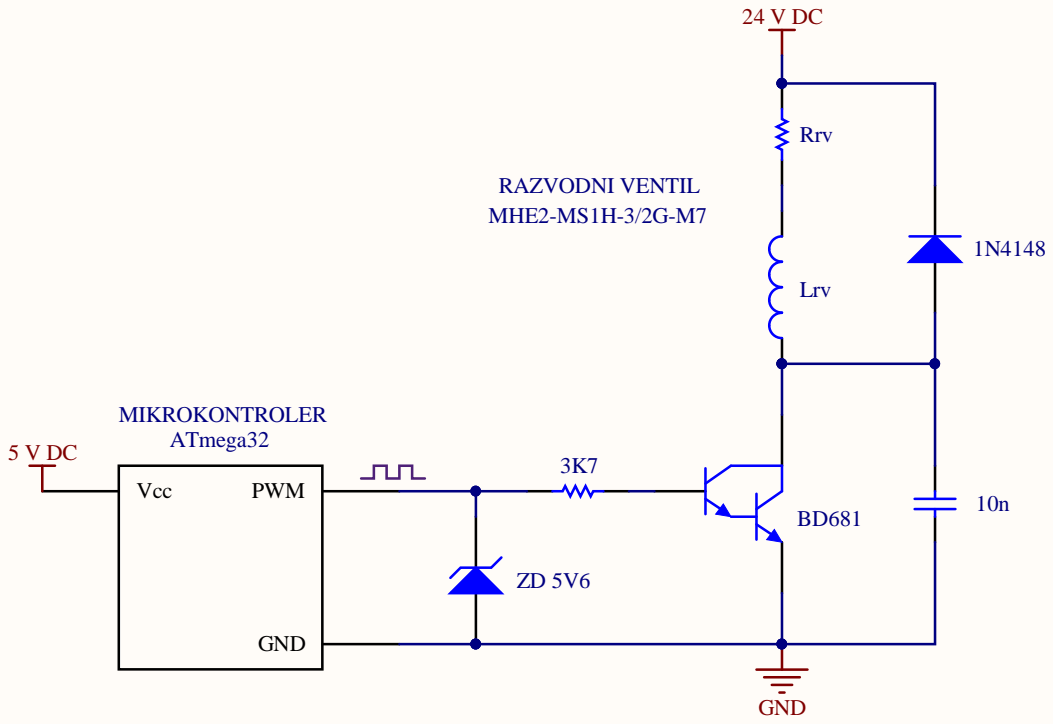
[picture p133: page 1]

Size A | Number | Revision

Date: 31/08/2020 | Sheet of
File: C:\Users\..\upravljanje razvodnikom.SchDocDrawn By:
