nikolaristic1995/Choice_Maker/(list of files, drawings)

Other design files:
Master rad/električna šema/biblioteka2.SchLib
Master rad/električna šema/biblioteka.SchLib
Master rad/električna šema/električna šema.SchDoc
Master rad/električna šema/napajanje.SchLib
Master rad/električna šema/prekidač.SchLib
Master rad/električna šema/Schlib1.SchLib
Master rad/električna šema/total stop.SchLib
Master rad/upravljanje razvodnikom/upravljanjeRazvodnikom/upravljanje razvodnikom.SchDoc
Master rad/upravljanje razvodnikom/upravljanjeRazvodnikom/upravljanjeRazvodnikom.PrjPcb
