nikolaristic1995/Choice_Maker/(commit log)

2020-08-13 stavio word dokument i elektro šemu
    [Schlib1.SchLib, biblioteka.SchLib, biblioteka2.SchLib, električna šema.SchDoc, napajanje.SchLib, prekidač.SchLib, total stop.SchLib]
2020-08-13 nova elektrošema dodata
    [električna šema.SchDoc]
2020-08-24 insertovanje koda u toku
2020-08-24 stao si do PWM_2 insertovanja u word
2020-08-30 ubacio assembly za animaciju
    [assembly - kuciste-1.STL, assembly - poklopac za kućište-1.STL, assembly.SLDASM, izvršni organ.SLDASM, kuciste.SLDPRT, kuciste.STL, kućište.SLDPRT, poklopac.SLDPRT]
2020-08-31 NOVE ELEKTRO SLIKE DODATE
    [električna šema.SchDoc, izvršni organ.SLDASM, minus.SLDPRT, plus.SLDPRT, poklopac.SLDPRT, upravljanje razvodnikom.SchDoc]
2020-09-04 došao do zahvalnice
    [assembly - kuciste-1.STL, assembly - poklopac za kućište-1.STL, assembly.SLDASM, kuciste.SLDPRT, kuciste.STL, poklopac.SLDPRT, poklopac.STL]
2020-09-06 dodao svrhu zener diode
2020-09-09 prilog 4 dodat
    [drzac membrane.SLDDRW]
